thisara7989/Fuel-Level-Monitoring-System/(list of files, drawings)

Other design files:
Fuel Level System Schematic.pdsprj
