thisara7989/Fuel-Level-Monitoring-System/(commit log)

2026-09-22 Revise README for Fuel Monitoring System
    Updated project description and added features, system architecture, hardware details, working principle, calibration, and pin configuration.
2026-09-22 Clean up README by removing unnecessary sections
    Removed sections on sensor measurement details, detailed documentation, and firmware information from the README.
